gvmarin/HordaCRTL/Termostato_cloud.cabos.pdf

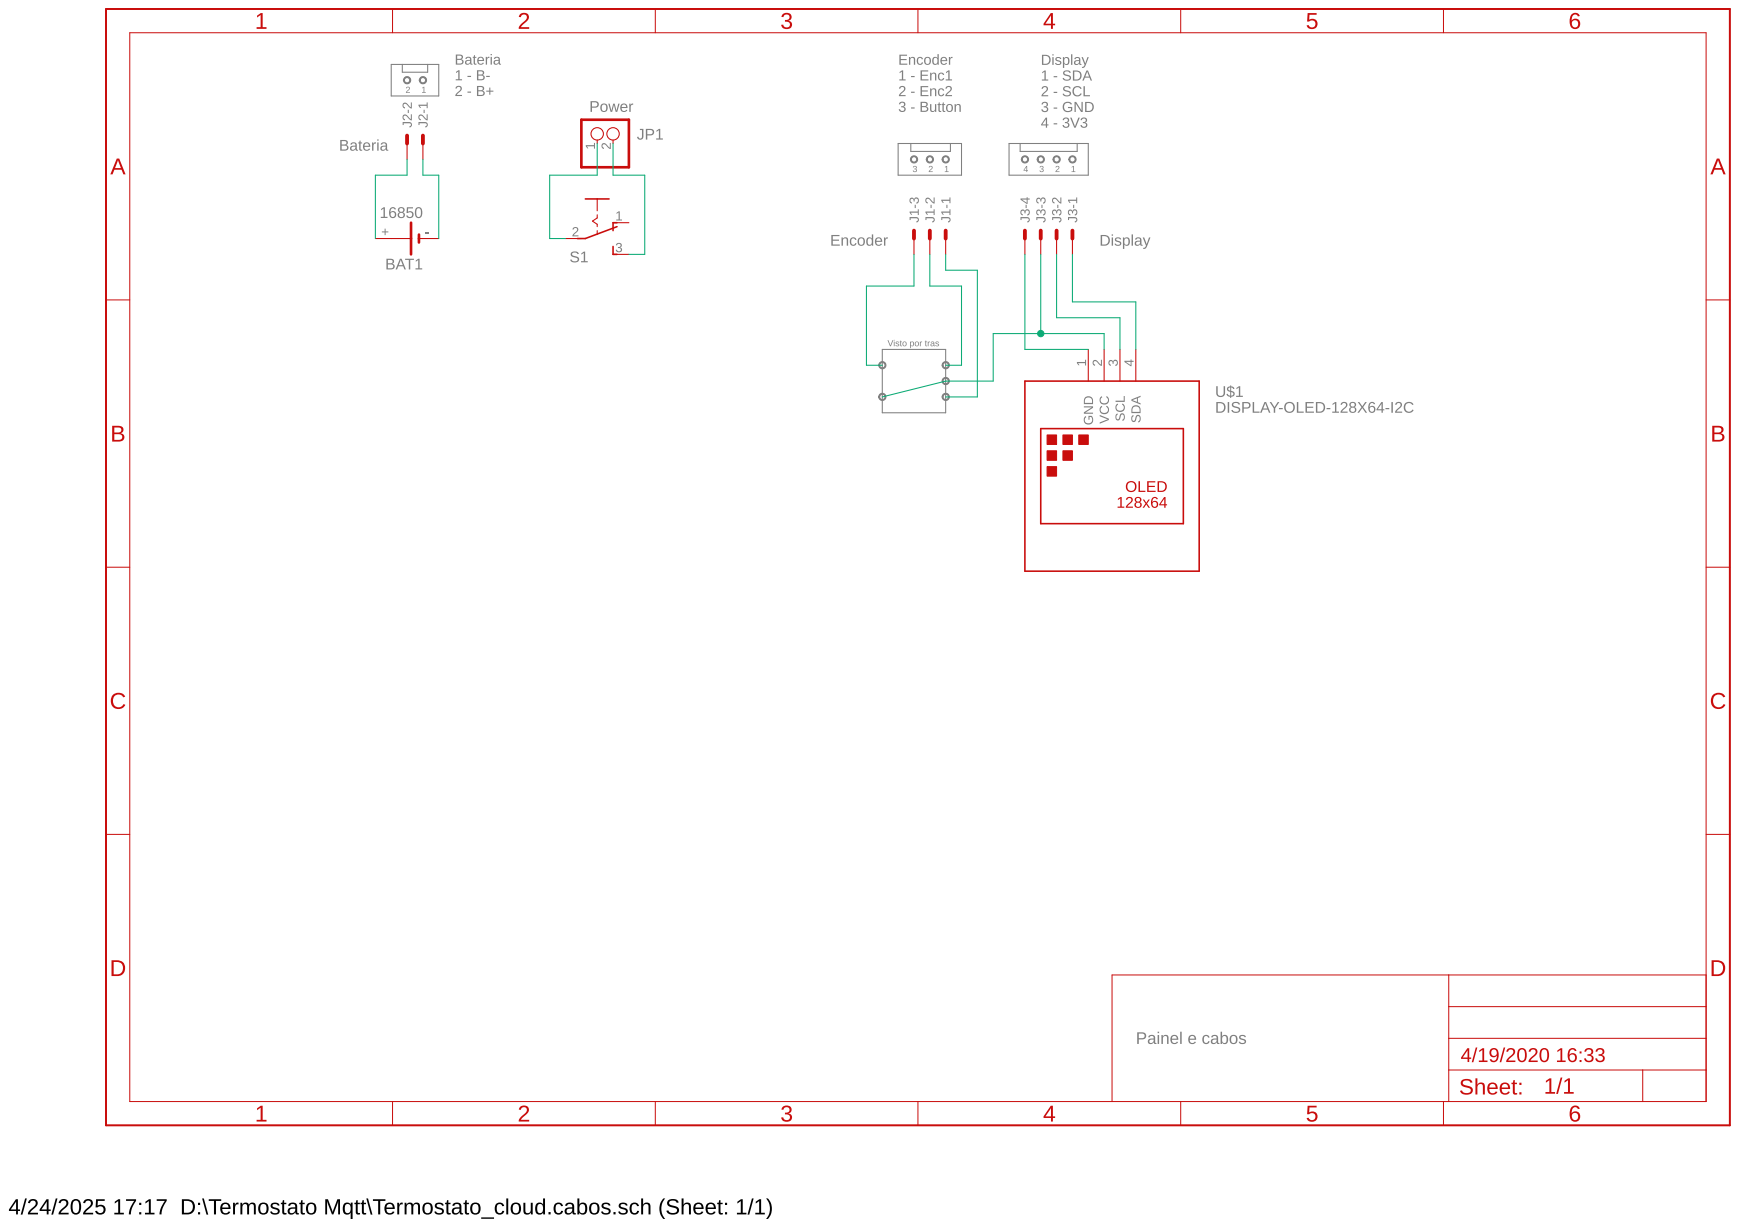
[picture p1: page 1]
