gvmarin/HordaCRTL/Termostato_cloud.esp12_adpt.pdf

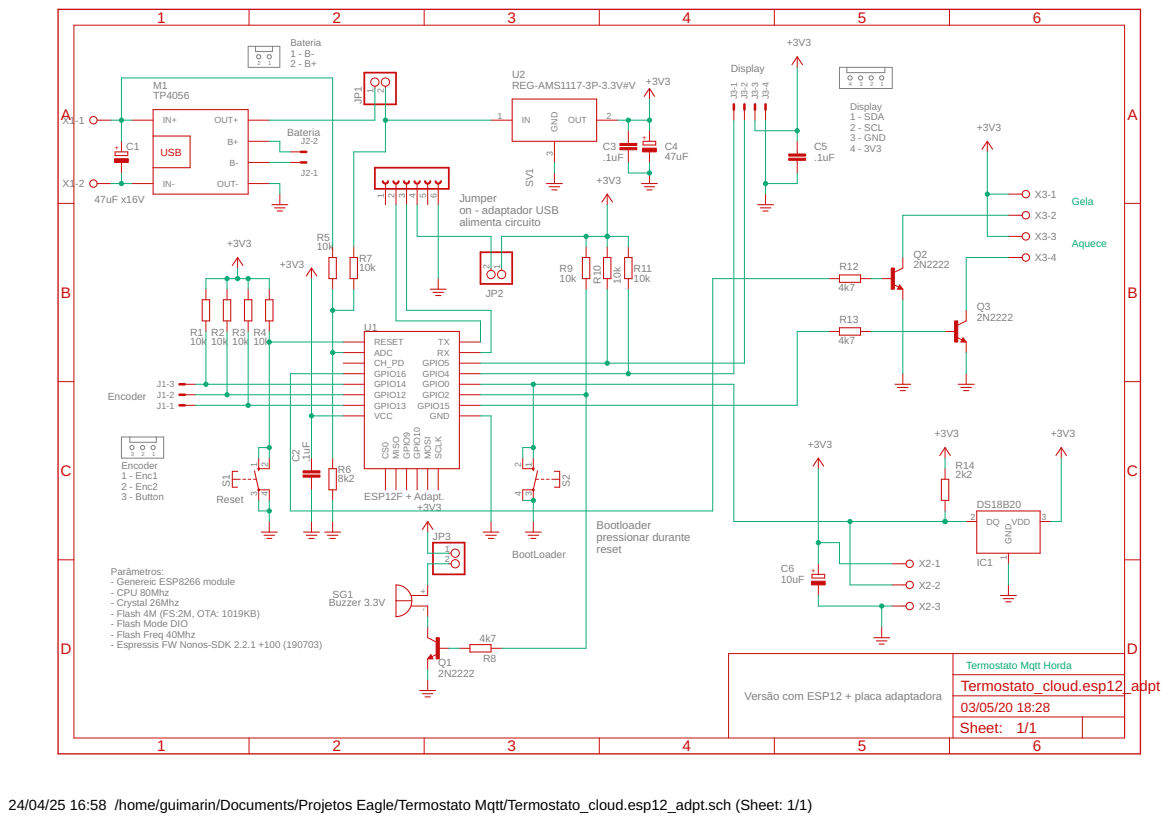
[picture p2: page 1]

+3V3 Bateria

Jumper on - adaptador USB

- CPU 80Mhz
- Crystal 26Mhz
- Flash 4M (FS:2M, OTA: 1019KB)
- Flash Mode DIO
- Flash Freq 40Mhz
- Espressis FW Nonos-SDK 2.2.1 +100 (190703)

Versão com ESP12 + placa adaptadora

24/04/25 16:58 /home/guimarin/Documents/Projetos Eagle/Termostato Mqtt/Termostato_cloud.esp12_adpt.sch (Sheet: 1/1)
